AchirawareElectronics/ACH-ESP32-C3F4/hardware/ACH-ESP32-C3F4-pinout.png

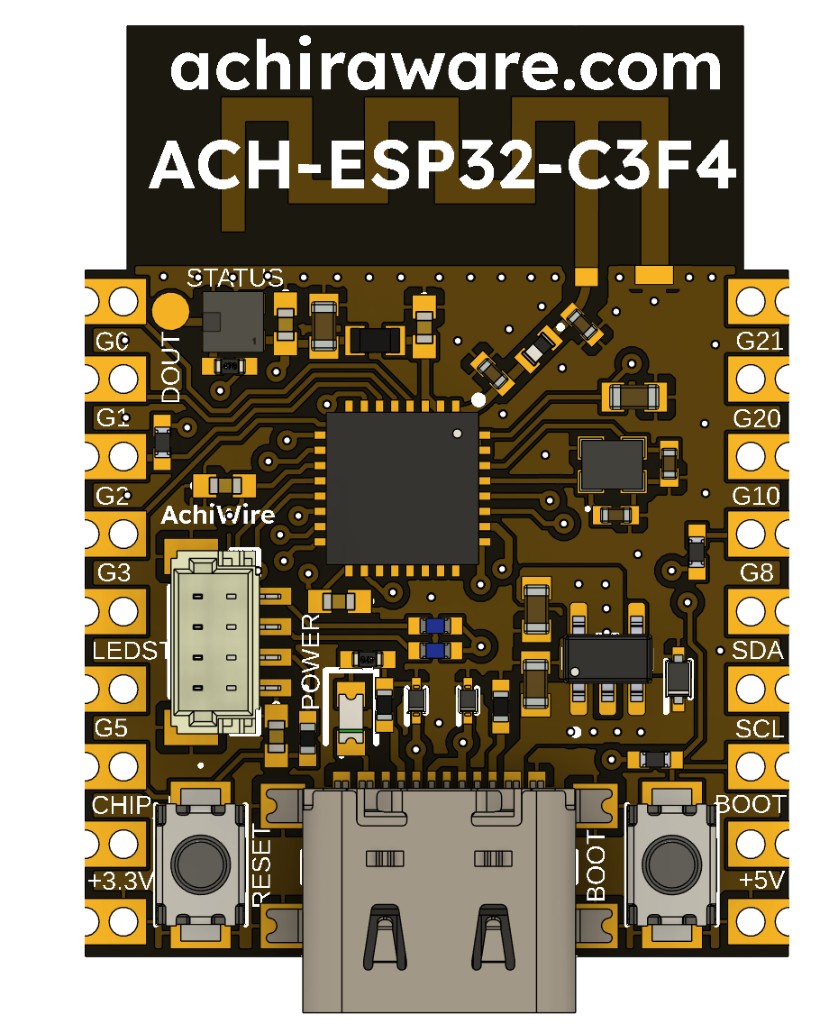
hardware/ACH-ESP32-C3F4-pinout.png
