AchirawareElectronics/ACH-ESP32-C3F4/hardware/ACH-ESP32-C3F4.step

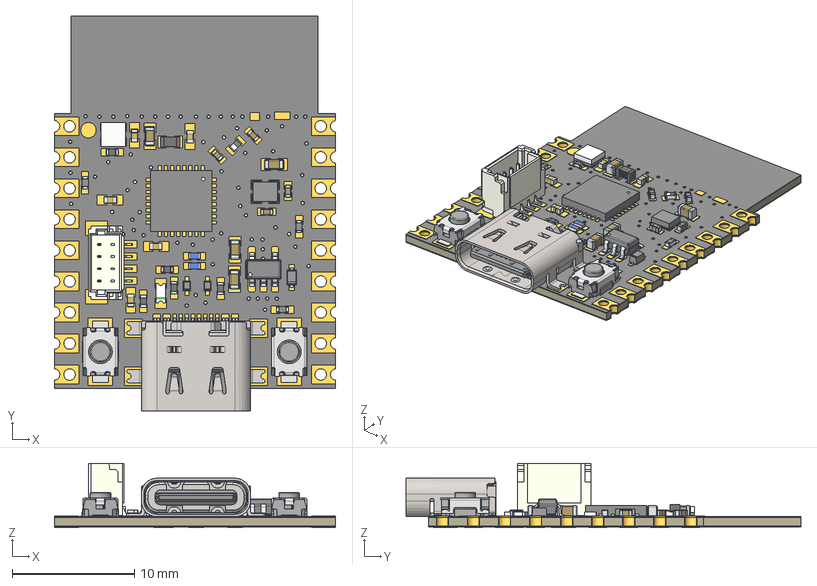
[picture p4: CAD file, 2026-09-20]
hardware/ACH-ESP32-C3F4.step
23.0 x 32.3 x 5.24 mm
Board
1-copper
16-copper
1-soldermask
16-soldermask
Pins
MHQ1005P1N8BTD25 v1
CR0402-JW-471GLF v1 x 2
ESP32-C3FH4 v1
C0402C104K4RAC3121 v1 x 5
RC0402FR-07100KL v1 x 3
term1
term2
MCS04020C4701FE000 v1 x 2
HSMG-C197 v1
term1 (1) x 2
term2 (1) x 2
BM04B-SRSS-TB(LF)(SN)-PIN
BM04B-SRSS-TB(LF)(SN)-BODY
PinKIdent x 2
PinK x 2
PinA x 2
Rect1
Rect2
Rect3
Rect4
Rect5
Rect6
Rect7
Rect8
Rect9
Rect10
Rect11
Rect12
Rect13
Rect14
Rect15
Rect16
Rect17
swt0110-020010ssa v1 x 2
UJ20-C-H-G-SMT-5-P16-TR v1
PinKIdent (1)
PinK (1)
PinA (1)
Pins (1)
TLV75733PDYDR v1
