AchirawareElectronics/ACH-ESP32-C3F4/(list of files, cad)

Other CAD files:
hardware/ACH-ESP32-C3F4.dxf
