AchirawareElectronics/ACH-ESP32-C3F4/hardware/ACH-ESP32-C3F4-schematic.pdf

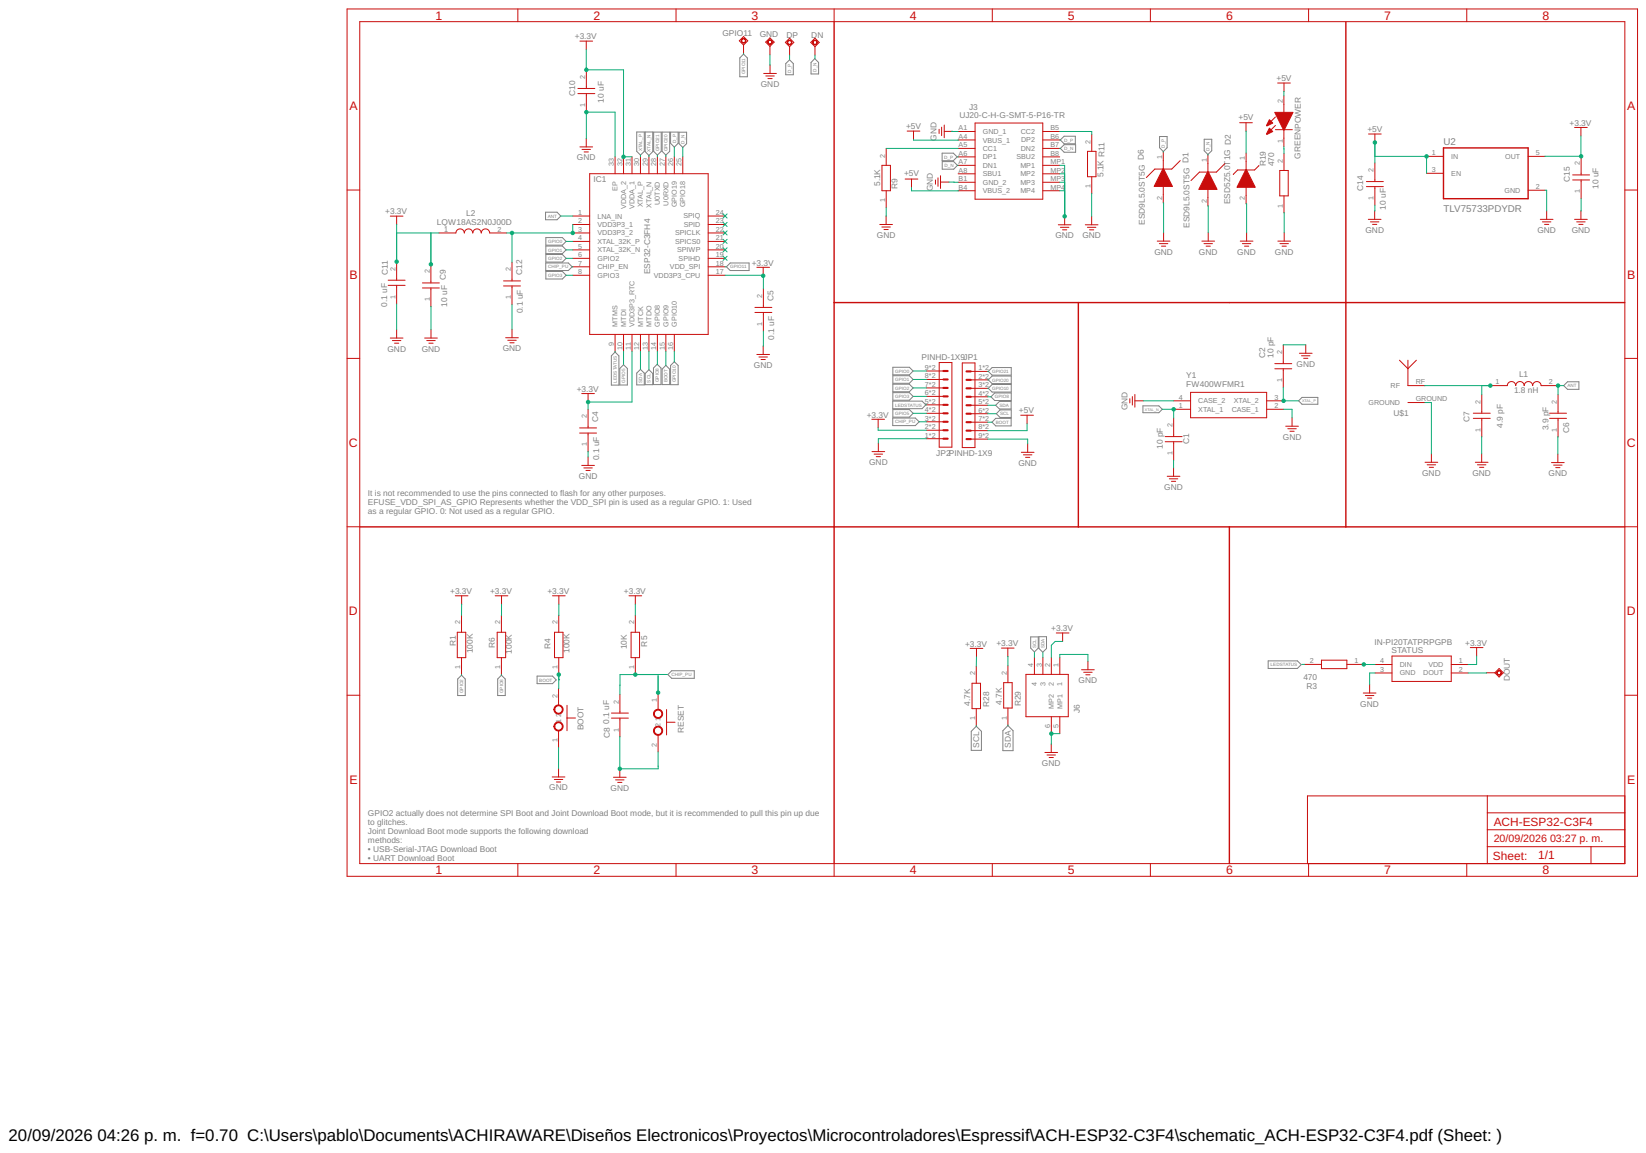
[picture p5: page 1]

+3.3V | GPIO11 | | +5V UJ20-C-H-G-SMT-5-P16-TR +5V | +3.3V

It is not recommended to use the pins connected to flash for any other purposes. EFUSE_VDD_SPI_AS_GPIO Represents whether the VDD_SPI pin is used as a regular GPIO. 1: Used

as a regular GPIO. 0: Not used as a regular GPIO.

GPIO2 actually does not determine SPI Boot and Joint Download Boot mode, but it is recommended to pull this pin up due
to glitches. Joint Download Boot mode supports the following download methods: • USB-Serial-JTAG Download Boot • UART Download Boot

20/09/2026 04:26 p. m. f=0.70 C:\Users\pablo\Documents\ACHIRAWARE\Diseños Electronicos\Proyectos\Microcontroladores\Espressif\ACH-ESP32-C3F4\schematic_ACH-ESP32-C3F4.pdf (Sheet: )
