AchirawareElectronics/ACH-ESP32-C3F4/(commit log)

2026-09-20 Add hardware files for the shop Downloads tab.
    Pinout, schematic, DXF outline and STEP model so customers can download them from GitHub.
    [ACH-ESP32-C3F4.dxf, ACH-ESP32-C3F4.step]
2026-10-10 docs: enrich README with RISC-V specs, 18-pin mapping, and HD infographics
2026-10-11 docs: replace Adafruit_NeoPixel with SimpleRGBLed in Arduino examples
